mcleinn/freexen/README.md

Building blocks for a DIY 56*x key velocity-sensitive microtonal keyboard
