mcleinn/freexen/3DPrintingPlates/sheath_0.15_top0.13.3mf

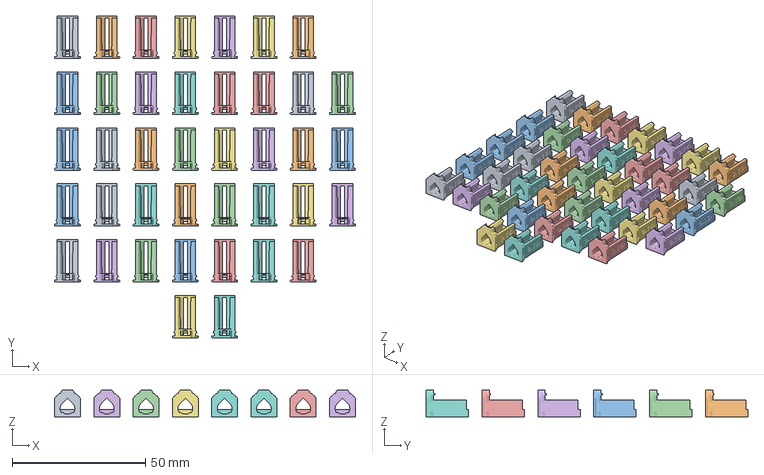
[picture p1: CAD file, 2025-05-10]
3DPrintingPlates/sheath_0.15_top0.13.3mf
113.0 x 120.8 x 10.0 mm
void_switch_15_op13.stl x 40
