mcleinn/freexen/xenCase/Shaft.stl

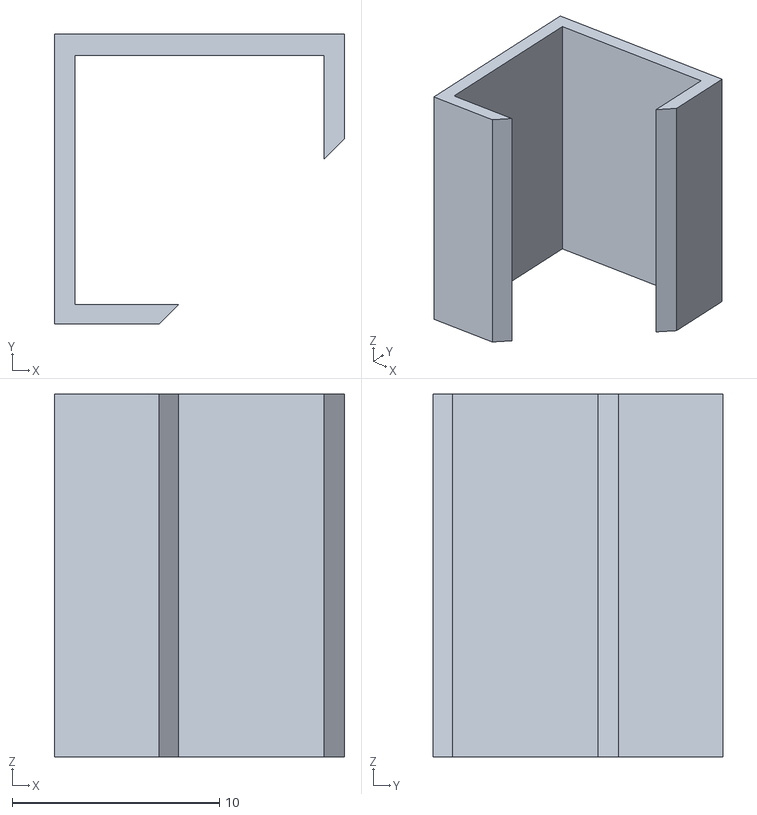
[picture p2: CAD file, 2025-02-27]
xenCase/Shaft.stl
14.0 x 14.0 x 17.5
