mcleinn/freexen/3DPrintingPlates/stem.3mf

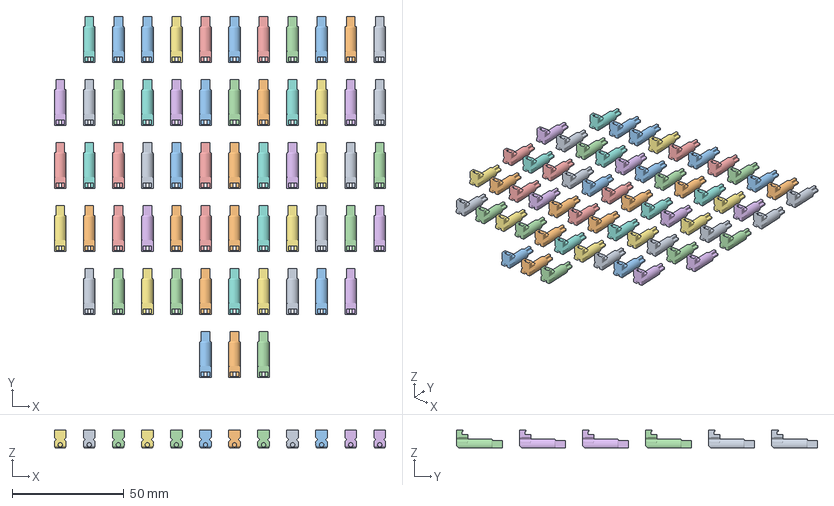
[picture p3: CAD file, 2025-03-23]
3DPrintingPlates/stem.3mf
148.6 x 161.8 x 7.93 mm
7.5_2.1_0.2_stem.stl x 60
