mcleinn/freexen/xenCase/module-top.stl

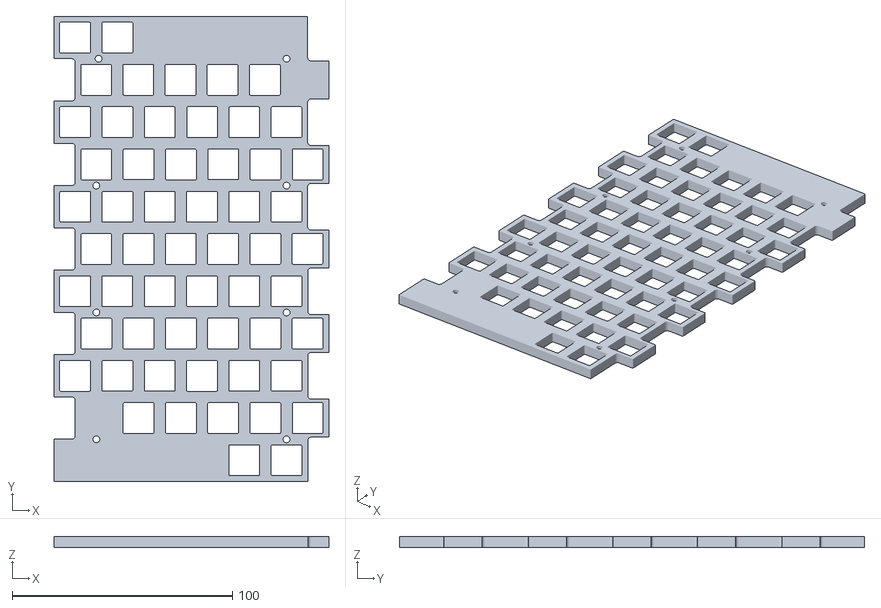
[picture p4: CAD file, 2025-02-27]
xenCase/module-top.stl
124.9 x 211.2 x 5.00
