mcleinn/freexen/3DPrintingPlates/module.3mf

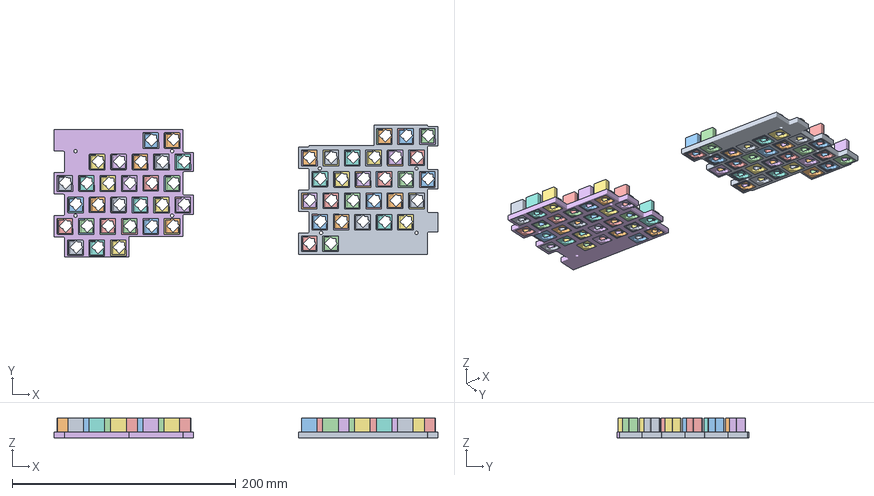
[picture p5: CAD file, 2025-02-27]
3DPrintingPlates/module.3mf
343.4 x 117.8 x 17.5 mm
Module-Top-B.stl
freexen-body.stl x 56
Module-Top-A.stl
Shaft.stl x 56
