mcleinn/freexen/xenCase/Module-Top-A.stl

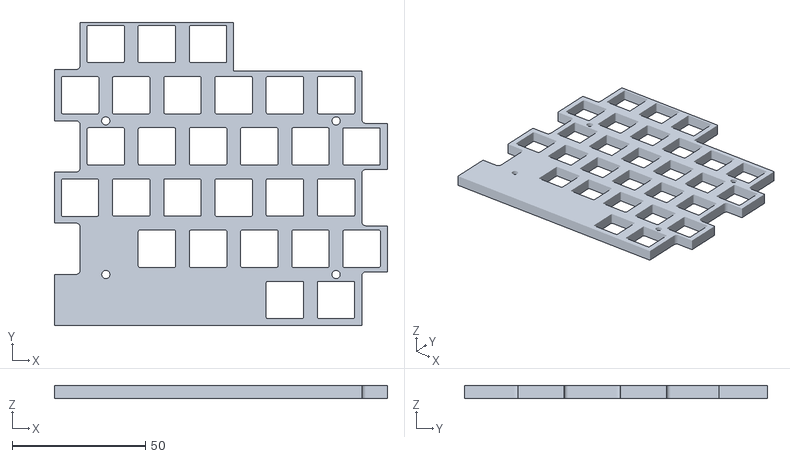
[picture p6: CAD file, 2025-02-27]
xenCase/Module-Top-A.stl
124.9 x 113.7 x 5.00
