mcleinn/freexen/3DPrintingPlates/assist-stems.3mf

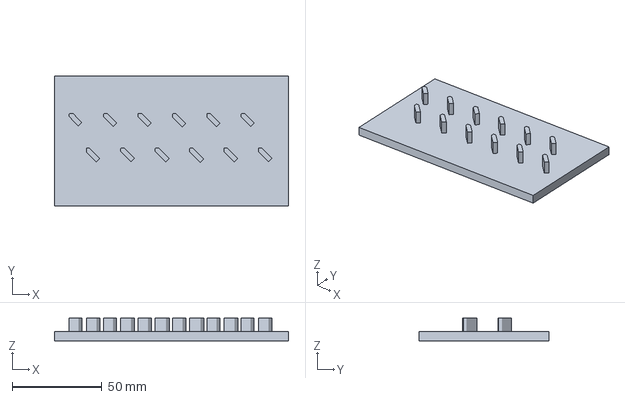
[picture p7: CAD file, 2025-02-27]
3DPrintingPlates/assist-stems.3mf
130.5 x 72.8 x 12.7 mm
