mcleinn/freexen/xenCase/Module-Top-B.stl

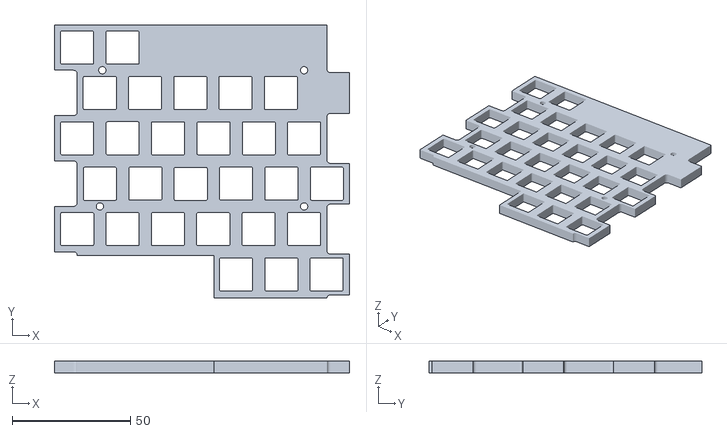
[picture p8: CAD file, 2025-02-27]
xenCase/Module-Top-B.stl
124.8 x 115.6 x 5.00
