mcleinn/freexen/3DPrintingPlates/assist-all.3mf

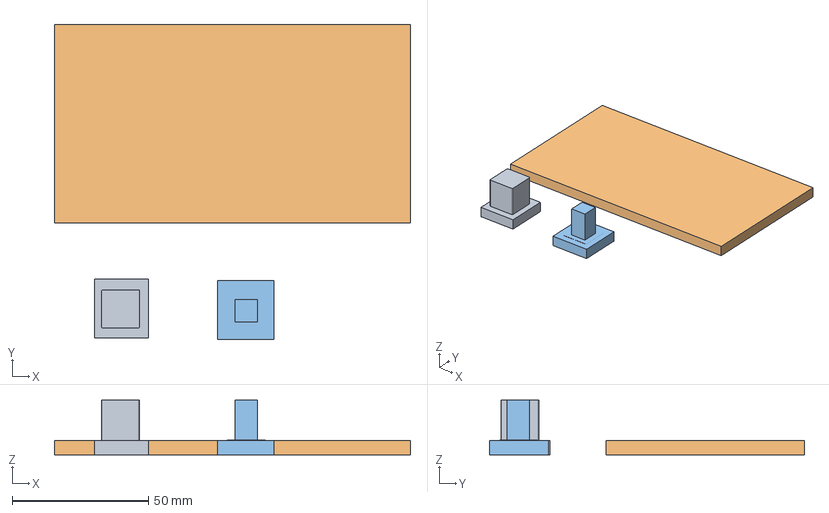
[picture p9: CAD file, 2025-02-27]
3DPrintingPlates/assist-all.3mf
130.5 x 115.4 x 20.0 mm
Assist Body.stl
Assist Plate.stl
assist-sheath.stl
