mcleinn/freexen/xenCase/frame-bay-open.dxf

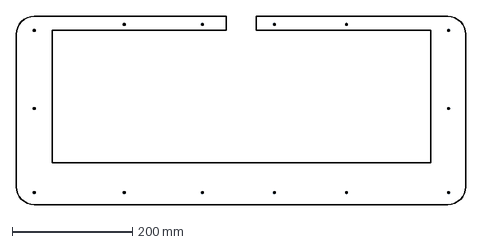
[picture p10: CAD file, 2025-02-24]
xenCase/frame-bay-open.dxf
748.7 x 313.2 mm
