mcleinn/freexen/3DPrintingPlates/bodies-wide.3mf

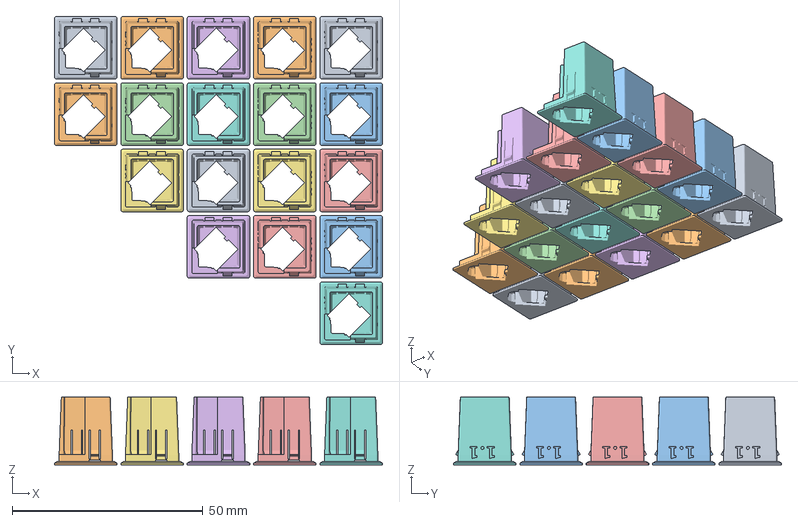
[picture p11: CAD file, 2025-02-24]
3DPrintingPlates/bodies-wide.3mf
86.0 x 86.0 x 17.7 mm
void_switch-wide.stl x 18
