mcleinn/freexen/xenCase/frame-bottom.dxf

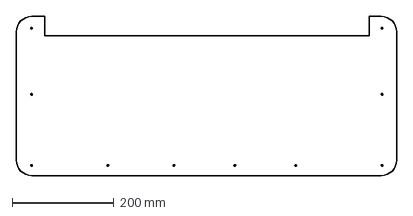
[picture p12: CAD file, 2025-02-24]
xenCase/frame-bottom.dxf
748.7 x 313.2 mm
