mcleinn/freexen/3DPrintingPlates/levitator.3mf

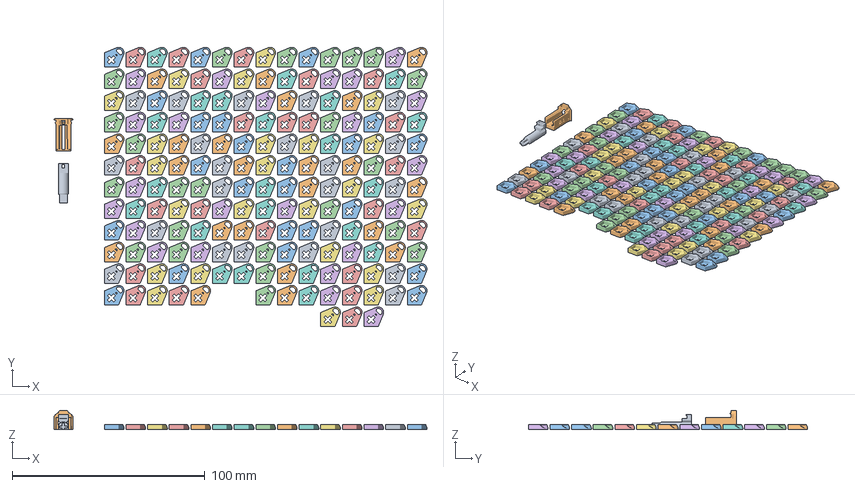
[picture p13: CAD file, 2025-02-24]
3DPrintingPlates/levitator.3mf
193.7 x 145.1 x 10.0 mm
7.5_2.1_0.2_stem.stl
7.5_2.1_0.15_sheath_wide.stl
levitator-my1.stl x 181
