mcleinn/freexen/xenCase/module_bottom.dxf

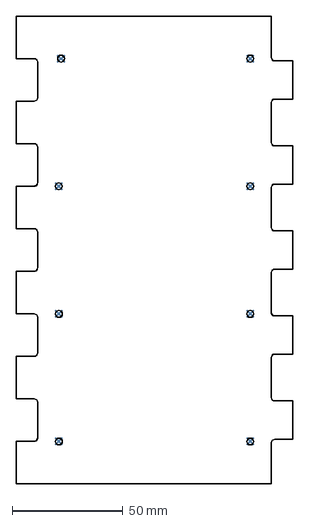
[picture p14: CAD file, 2025-02-24]
xenCase/module_bottom.dxf
124.8 x 211.2 mm
