mcleinn/freexen/3DPrintingPlates/sheath.3mf

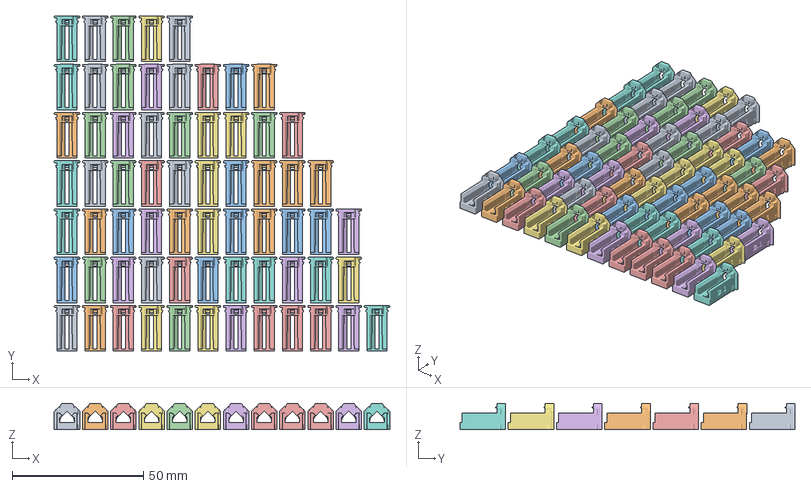
[picture p15: CAD file, 2025-02-24]
3DPrintingPlates/sheath.3mf
128.0 x 127.8 x 10.0 mm
sheath_longer.stl x 66
