mcleinn/freexen/xenCase/frame-middle.dxf

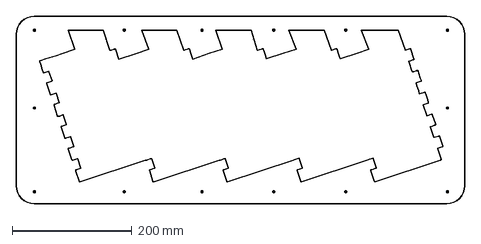
[picture p16: CAD file, 2025-02-24]
xenCase/frame-middle.dxf
748.7 x 313.2 mm
