mcleinn/freexen/3DPrintingPlates/bodies.3mf

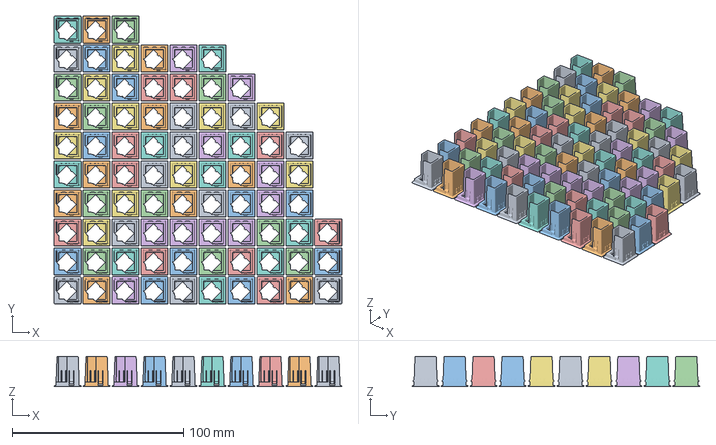
[picture p17: CAD file, 2025-02-24]
3DPrintingPlates/bodies.3mf
168.0 x 168.0 x 17.7 mm
mybody1.stl x 81
