mcleinn/freexen/xenCase/frame-bay-bottom.dxf

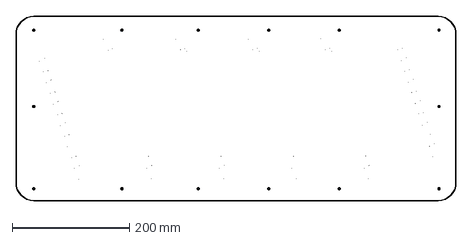
[picture p18: CAD file, 2025-02-24]
xenCase/frame-bay-bottom.dxf
748.7 x 313.2 mm
