mcleinn/freexen/3DPrintingPlates/sheath-stem.3mf

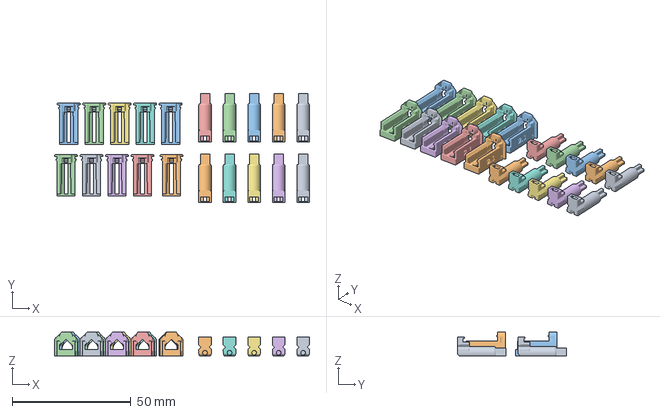
[picture p19: CAD file, 2025-02-24]
3DPrintingPlates/sheath-stem.3mf
107.6 x 46.2 x 10.0 mm
7.5_2.1_0.2_stem.stl x 10
sheath_longer.stl x 10
