mcleinn/freexen/xenCase/frame-top.dxf

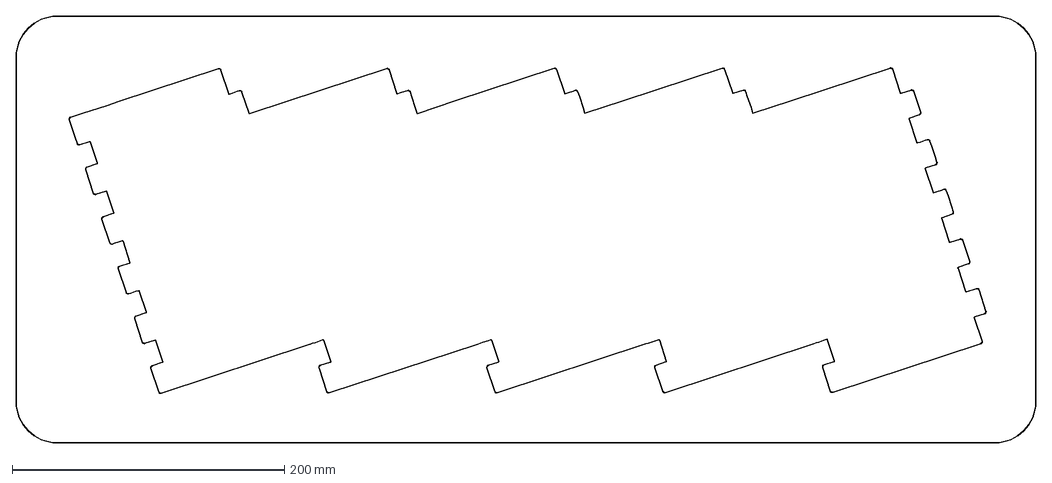
[picture p20: CAD file, 2025-02-24]
xenCase/frame-top.dxf
748.7 x 313.2 mm
