mcleinn/freexen/xenCase/frame-bay-closed.dxf

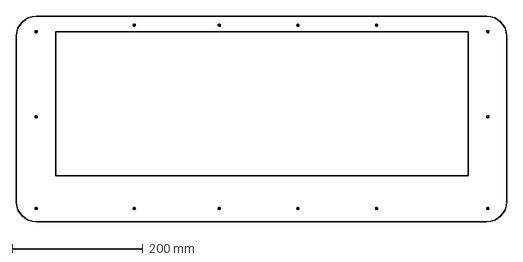
[picture p21: CAD file, 2025-02-24]
xenCase/frame-bay-closed.dxf
748.7 x 313.2 mm
