mcleinn/freexen/xenCase/dustcover.dxf

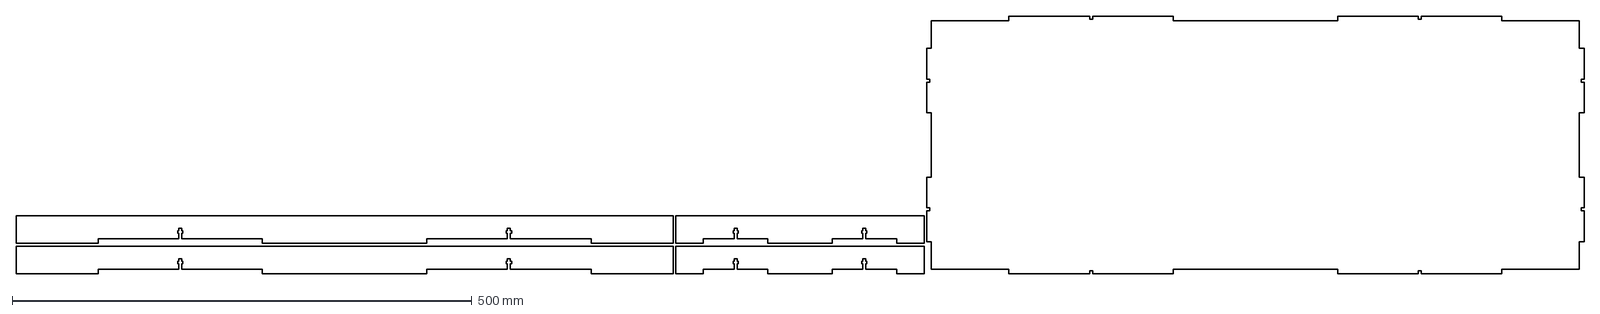
[picture p22: CAD file, 2025-02-24]
xenCase/dustcover.dxf
1706.0 x 280.0 mm
