mcleinn/freexen/xenCase/top_plane-felt.dxf

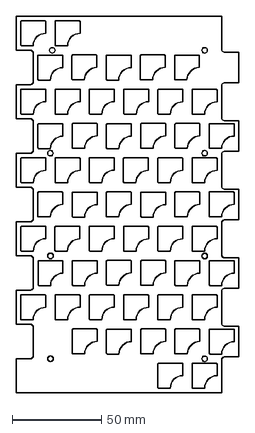
[picture p23: CAD file, 2025-02-24]
xenCase/top_plane-felt.dxf
124.8 x 211.2 mm
