mcleinn/freexen/(list of files, cad)

Other CAD files:
xenCase/module_top.dxf
