mcleinn/freexen/xenFirmware/XenTest2/TEST_LOG.md

# XenControl Firmware Test & Modification Log

This log is append-only. Each entry captures:
- firmware version (`ver`)
- date/time
- what changed
- key test results + brief analysis

## 2026-02-22 10:14:58

### fw=16

Tuning run: a4 + sd5

Results (COM3)
- `sd5` applied.
- `a4` applied.
- `rate1000` after a4+sd5:
  - muxStepsPerSec: 3864
  - keysPerSec: 6440
- `pr2` after a4+sd5 (head only):
  - sigma (keys 1..5): ~2.4–3.8 mV
  - `thrSuggest` mostly clamps at 30 mV
- `sts1,57` after a4+sd5:
  - best delay_us in {0,5,10,20,50,100,200}: 100 us
  - best score (maxErr): 8.159 mV
- `teste` after a4+sd5:
  - avg=4: keysPerSec ~43120, sigmaP95 ~7.74 mV
  - avg=8: keysPerSec ~23520, sigmaP95 ~7.30 mV
  - avg=16: keysPerSec ~12320, sigmaP95 ~6.38 mV
  - avg=32: keysPerSec ~6440,  sigmaP95 ~5.13 mV

Notes
- Settling sweep appears noisy/unstable across runs; we should pick a worst-case key pair explicitly and run multiple repetitions.
- Test output is still interleaved with peak-detect debug prints; add a quiet/test-only flag to suppress those during diagnostics.

Changes
- Reverted serial command parsing to leading-letters tokens.
- Renamed tests to letter-only commands (`testa..teste`).

Non-interactive test results (COM3)
- `rate1000`:
  - muxStepsPerSec: 3696
  - adcReadsPerSec / keysPerSec: 6182
  - full-scan-equivalent (280 keys): ~45 ms
- `pr2` (2s noise survey):
  - typical sigma: ~3–5 mV
  - `thrSuggest = max(30 mV, 8*sigma)` => often 30 mV clamp
  - most keys uncalibrated (`hasZero=0`), expected
- `sts1,57` (settle sweep, keyA=1 keyB=57, 50 samples):
  - best delay_us in {0,5,10,20,50,100,200}: 5 us
  - best score (maxErr): 6.749 mV
- `teste` (averaging sweep; p95 sigma vs throughput):
  - avg=1:  ~85960 keys/s, sigmaP95 ~14.36 mV
  - avg=2:  ~85960 keys/s, sigmaP95 ~14.14 mV
  - avg=4:  ~38360 keys/s, sigmaP95 ~7.77 mV
  - avg=8:  ~22120 keys/s, sigmaP95 ~7.29 mV
  - avg=16: ~12040 keys/s, sigmaP95 ~6.15 mV
  - avg=32: ~6440 keys/s,  sigmaP95 ~4.98 mV

Analysis
- Averaging sweet spot looks like 4 or 8 (big noise reduction vs large speed gain over 32).
- Mux settle delay could likely be reduced from 10 us to ~5 us, but should be re-tested on a worst-case key pair.
- Some debug prints suggest scan/peak logic may still run during tests; tests should run in a quiet mode for cleaner logs.

## 2026-02-22 10:20:03

### fw=16

Tuning run: a4 sd5 rate/pr/sts/teste

## 2026-02-22 10:22:00

### fw=17

Changes
- Added diagnostic mode gating so helpers/tests run without normal scanning or peak detection.
- Wrapped long-running helpers/tests with diag begin/end so they take over LEDs and timing.

Run (COM3)
- `fmt1`, `a4`, `sd5`
- `rate1000`
- `k1,280` + `pr2`
- `sts1,57`
- `teste`

Results
- `ver`: fw=17
- `rate1000` (after a4+sd5, diag mode):
  - muxStepsPerSec: 25872
  - keysPerSec: 43274
  - full-scan-equivalent (280 keys): ~6.5 ms
- `pr2` (2s noise survey, head):
  - typical sigma (keys 1..30): ~1.1–1.9 mV
  - `thrSuggest` still clamps at 30 mV for most keys
- `sts1,57` (settle sweep, 50 samples):
  - best delay_us in {0,5,10,20,50,100,200}: 50 us
  - best score (maxErr): 5.339 mV
  - observed outlier at 0 us (maxErrAB ~17.4 mV)
- `teste` (averaging sweep, p95 sigma vs throughput):
  - avg=1:  keysPerSec ~115640, sigmaP95 ~10.14 mV
  - avg=4:  keysPerSec ~43120,  sigmaP95 ~5.14 mV
  - avg=8:  keysPerSec ~23520,  sigmaP95 ~3.98 mV
  - avg=16: keysPerSec ~12320,  sigmaP95 ~2.86 mV
  - avg=32: keysPerSec ~6440,   sigmaP95 ~2.38 mV

Analysis
- With diag gating, rate/noise measurements are much cleaner and faster.
- Averaging sweet spot remains 4–8 depending on responsiveness vs cleanliness.
- Mux settle delay of 0 us can create rare but large carryover spikes; 10–50 us looks safer.

## 2026-02-22 10:34:00

### fw=18

Changes
- Added discard-first-sample ADC reads after each mux switch in runtime scan and noise scan.

Results (COM3)
- `teste` (averaging sweep, p95 sigma vs throughput):
  - avg=1:  keysPerSec ~85960, sigmaP95 ~12.39 mV
  - avg=2:  keysPerSec ~85960, sigmaP95 ~12.60 mV
  - avg=4:  keysPerSec ~38360, sigmaP95 ~5.69 mV
  - avg=8:  keysPerSec ~22120, sigmaP95 ~4.31 mV
  - avg=16: keysPerSec ~12040, sigmaP95 ~3.26 mV
  - avg=32: keysPerSec ~6440,  sigmaP95 ~2.59 mV

Analysis
- After discard-first-sample, avg=4 is still a good default for responsiveness.
- avg=8 is a nice "clean" mode with ~1.3x lower sigmaP95 than avg=4 but ~1.7x slower.

## 2026-02-22 10:40:00

### fw=19

Changes
- Set default ADC averaging to 4 on boot (previously 32).

Verification
- `ver`: fw=19

## 2026-02-22 12:54:02

### fw=28

Results (testb JSONL)
- `testb_done`: passCount=20 failCount=0 total=20 pass=1
- Typical baseline: ~1.66–1.73 V
- Typical sigma: ~1.3–2.0 mV
- Threshold used: 30 mV (minThr clamp)
- Notable low swing sentinel: key 169 (board 4 key 1) maxSwing ~58 mV (still passed)

testb full run (JSONL) pass=20 fail=0

## 2026-02-22 13:06:42

### fw=30

Results (testb JSONL)
- `testb_done`: passCount=23 failCount=0 total=23 pass=1
- Polarity distribution (from `testb_row.pol`): +1 = 16, -1 = 7
- Weakest sentinel: key 169 (board 4 key 1) maxSwing ~58.9 mV, pol=-1 (still passed at thr=30 mV)

testb updated: includes pol + extra subtest keys

## 2026-02-22 14:37:10

### fw=38

Calibrate board 1 (k1,56) after calib/testb parity

Run (COM3)
- Connected later (DTR) -> debug banner includes `fw=38` and `calibAutoLoadOk=0`.
- `fmt1`
- `k1,56`
- `ccalib`
- `x` (guided calibration for keys 1..56)

Key findings
- Calibration now emits `testb`-style baseline logs per key (baseline/sigma/thr/min/max) and uses discard-first-sample after mux switch during baseline capture.
- Key 3, which previously produced inflated sigma/threshold, calibrated normally.
- Calibration completed for all 56 keys with no issues:
  - `calib_done`: Skipped=0, NotTriggering=0, SelfTriggering=0, NotReleasing=0
- Persistence/coverage after run:
  - `calstat`: hasZero=56, hasThr=56, nSigma=56
  - observed sigma range on board 1: minSigma~0.001365, maxSigma~0.001911

## 2026-02-22 16:23:06

### fw=53

Calibrate board 3 (k113,168) with stuck-issue persistence

Run (COM3)
- `fmt1`
- `k113,168`
- `x` (guided calibration for board 3)

Results
- Overall after run: `calstat hasZero=167 hasThr=168 nSigma=168` (boards 1-3 attempted)
- After `scalib` + `lcalib`: `calstat hasZero=167 hasThr=167 nSigma=167`
- Board 3 coverage: `dcalib` shows 55/56 keys calibrated (1 key failed)

Issues (board 3)
- `calissues` for `k113,168`: `NotReleasing=1` (others 0)
- Failing key: global key 120 (1-based), board 3 key 8 (1-based)
  - JSON: `{"type":"calissue_row","key":119,"board":2,"boardKey":7,"notReleasing":1}`
- SD persistence: `dmeta` confirms the same key has `notReleasing=1`

Quality snapshot (board 3, calibrated keys)
- Weakest maxSwing: key 114 (boardKey 2) ~0.030155 V (near 30 mV clamp)
- Noisiest sigma: max ~0.001737 V (key 148 / boardKey 36)

## 2026-02-22 16:32:29

### fw=53

Calibrate boards 4 (k169,224) and 5 (k225,280)

Board 4 run (COM3)
- `fmt1`
- `k169,224`
- `x`

Board 4 results
- `calissues` for `k169,224`: Skipped=0, NotTriggering=0, SelfTriggering=0, NotReleasing=0, SlightlyStuck=0
- `dcalib` (board 4): 56/56 calibrated
- Polarity skew (board 4): pol+1=7, pol-1=49
- Sigma (board 4): min~0.001272, max~0.002519 (key 199 / boardKey 31 is the main outlier)
- Weakest maxSwing (board 4): key 170 (boardKey 2) ~0.030718 V (near 30 mV clamp)

Board 5 run (COM3)
- `fmt1`
- `k225,280`
- `x`

Board 5 results
- `calissues` for `k225,280`: Skipped=0, NotTriggering=0, SelfTriggering=0, NotReleasing=0, SlightlyStuck=0
- `dcalib` (board 5): 56/56 calibrated
- Sigma (board 5): min~0.001212, max~0.001753
- Weakest maxSwing (board 5): key 279 (boardKey 55) ~0.032776 V; key 277 (boardKey 53) ~0.033400 V

Overall after board 5
- `calstat`: hasZero=279, hasThr=279, nSigma=279 (one key still uncalibrated from board 3 NotReleasing)
- After `scalib` + `lcalib`: `calstat` unchanged

## 2026-02-22 17:43:18

### fw=56

Autotune avg/sd + per-key thresholds (RAM-only)

Goal
- Find runtime settings that yield `idle60 total=0` (no offenders) while keeping thresholds as low as possible.

Implementation notes (fw=56)
- `autotune<tuneSeconds>,<validateSeconds>,<candidateN>` now runs a fast grid search over global `avg` and `sd` using a short idle window, then for the top candidates does a one-shot per-key threshold raise based on observed max excursion (`maxExc + 5mV` margin), then strict-validates with `idle<validateSeconds>`.
- Logging is stored in RAM (single run) and dumped with `autodump` (non-spam during run).

Run (COM3)
- `fmt1`
- `k1,280`
- `autotune5,60,2`
- `autodump`
- `idle60`

Results
- `autodump` best: `bestAvg=32 bestSd_us=5 bestTuneTotal=0 bestValidateTotal=2` (not yet perfect)
- Manual `idle60` immediately after: `total=1` with top offender `key=8` (0-based) count=1

Analysis
- Short tune windows (5s) can miss rare spikes that appear in strict validation (60s). The one-shot threshold update based only on tune-window max excursion can therefore under-shoot slightly.
- Next improvement: if `validateTotal>0`, do a targeted adjustment step for keys that offend during validation (raise their thresholds using validation-window max excursion + margin), then re-validate until `total==0` or thresholds reach `maxThr`.

## 2026-02-22 18:26:14

### fw=58

Staged autotune (avg/sd grid + per-key thresholds)

Run (COM3)
- `fmt1`
- `k1,280`
- `autotune5,20,60,2`
- `autodump` (saved to local JSONL as well)
- `idle60` (post-check)

Result
- `autodump` best: `bestAvg=32 bestSd_us=5 bestTuneTotal=0 bestValidateTotal=0`
- Max threshold after tuning: `maxThr=0.048461` (key 86, 0-based)
- Threshold adjustments were minimal; only one key needed a raise in the winning candidate:
  - key 82 (0-based) maxExc~0.035779 -> thrAfter~0.045779

Local artifact
- `autotune_logs\autodump_fw58_20260222_181911.jsonl`

Notes
- This staged approach converged within the time budget and achieved strict `idle60 total=0` on the internal strict-validation stage.
- Post-check `idle60` should be re-run occasionally (and extended to `idle90`/`idle120`) to confirm rare spikes remain suppressed.

## 2026-02-22 20:47:31

### fw=66

Autotune bugfix: best candidate always set; idle120=0

Fix
- Autotune now always seeds `_autoBest*` from Stage A so `autodump` never reports INT_MAX sentinels.
- Strict loop now re-measures after each adjustment so `strictTotal` is always finite.
- `autodump` includes `complete` flag.

Run (COM3)
- `fmt1`
- `k1,280`
- `autotune5,20,120,2`
- external `idle120`
- `autodump` captured to local file

Results
- `idle120`: `total=0`
- `autodump` best: `bestAvg=32 bestSd_us=20 bestTuneTotal=0 bestValidateTotal=0`
- Threshold raises: none required (`maxThr=0.03` baseline)

Artifacts
- `autotune_logs\autodump_fw66_capture_20260222_204708.jsonl`

## 2026-02-23 18:08:53

### fw=90

Autotune saved (2-min defaults). LOW noise; idle120=1; overlay enabledKeys=279 avg=32 sd_us=100 maxThr=0.125V key=60; dynStepsMin=9 key=41 dynStepsMax=127 key=168 dynDeadN=0 scansPerSec=8 revisitMsEst=125ms
