mcleinn/freexen/(list of files, drawings)

Other design files:
xenControl/ProPrj_Xen_2025-02-04.epro
