mcleinn/freexen/xenIO/void_switch_keyboard.kicad_pcb

## KiCad design xenIO/void_switch_keyboard.kicad_pcb (2025-02-24)

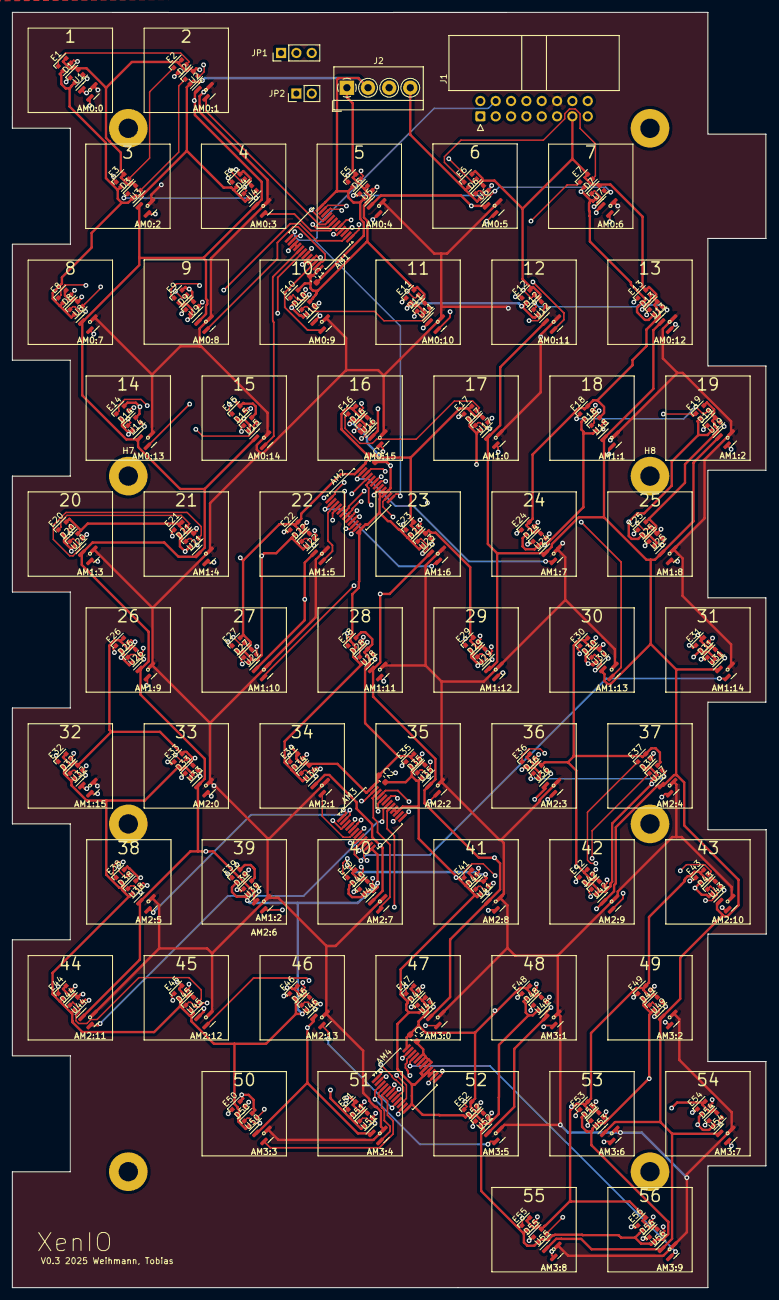
[picture p24: board void_switch_keyboard.kicad_pcb from above]

Board: 4 copper layers, 124.8 x 211.2 mm, 244 parts (0 on the bottom side), 183 nets.

Parts:
AM0:0: 1; VoidSwitch_1u_SMD
AM0:1: 2; VoidSwitch_1u_SMD
AM0:2: 3; VoidSwitch_1u_SMD
AM0:3: 4; VoidSwitch_1u_SMD
AM0:4: 5; VoidSwitch_1u_SMD
AM0:5: 6; VoidSwitch_1u_SMD
AM0:6: 7; VoidSwitch_1u_SMD
AM0:7: 8; VoidSwitch_1u_SMD
AM0:8: 9; VoidSwitch_1u_SMD
AM0:9: 10; VoidSwitch_1u_SMD
AM0:10: 11; VoidSwitch_1u_SMD
AM0:11: 12; VoidSwitch_1u_SMD
AM0:12: 13; VoidSwitch_1u_SMD
AM0:13: 14; VoidSwitch_1u_SMD
AM0:14: 15; VoidSwitch_1u_SMD
AM0:15: 16; VoidSwitch_1u_SMD
AM1, AM2, AM3, AM4: CD74HC4067SM; SSOP-24_5.3x8.2mm_P0.65mm
AM1:0: 17; VoidSwitch_1u_SMD
AM1:1: 18; VoidSwitch_1u_SMD
AM1:2: 19; VoidSwitch_1u_SMD
AM1:3: 20; VoidSwitch_1u_SMD
AM1:4: 21; VoidSwitch_1u_SMD
AM1:5: 22; VoidSwitch_1u_SMD
AM1:6: 23; VoidSwitch_1u_SMD
AM1:7: 24; VoidSwitch_1u_SMD
AM1:8: 25; VoidSwitch_1u_SMD
AM1:9: 26; VoidSwitch_1u_SMD
AM1:10: 27; VoidSwitch_1u_SMD
AM1:11: 28; VoidSwitch_1u_SMD
AM1:12: 29; VoidSwitch_1u_SMD
AM1:13: 30; VoidSwitch_1u_SMD
AM1:14: 31; VoidSwitch_1u_SMD
AM1:15: 32; VoidSwitch_1u_SMD
AM2:0: 33; VoidSwitch_1u_SMD
AM2:1: 34; VoidSwitch_1u_SMD
AM2:2: 35; VoidSwitch_1u_SMD
AM2:3: 36; VoidSwitch_1u_SMD
AM2:4: 37; VoidSwitch_1u_SMD
AM2:5: 38; VoidSwitch_1u_SMD
AM2:6: 39; VoidSwitch_1u_SMD
AM2:7: 40; VoidSwitch_1u_SMD
AM2:8: 41; VoidSwitch_1u_SMD
AM2:9: 42; VoidSwitch_1u_SMD
AM2:10: 43; VoidSwitch_1u_SMD
AM2:11: 44; VoidSwitch_1u_SMD
AM2:12: 45; VoidSwitch_1u_SMD
AM2:13: 46; VoidSwitch_1u_SMD
AM3:0: 47; VoidSwitch_1u_SMD
AM3:1: 48; VoidSwitch_1u_SMD
AM3:2: 49; VoidSwitch_1u_SMD
AM3:3: 50; VoidSwitch_1u_SMD
AM3:4: 51; VoidSwitch_1u_SMD
AM3:5: 52; VoidSwitch_1u_SMD
AM3:6: 53; VoidSwitch_1u_SMD
AM3:7: 54; VoidSwitch_1u_SMD
AM3:8: 55; VoidSwitch_1u_SMD
AM3:9: 56; VoidSwitch_1u_SMD
C1, C2, C3, C4: 0.1uF; C_0603_1608Metric
D1, D2, D3, D4, D5, D6, D7, D8, D9, D10, D11, D12, D13, D14, D15, D16, D17, D18, D19, D20, D21, D22, D23, D24, D25, D26, D27, D28, D29, D30, D31, D32, D33, D34, D35, D36, D37, D38, D39, D40, D41, D42, D43, D44, D45, D46, D47, D48, D49, D50, D51, D52, D53, D54, D55, D56: WS2812B-2020; LED_WS2812B-2020_PLCC4_2.0x2.0mm
E1, E2, E3, E4, E5, E6, E7, E8, E9, E10, E11, E12, E13, E14, E15, E16, E17, E18, E19, E20, E21, E22, E23, E24, E25, E26, E27, E28, E29, E30, E31, E32, E33, E34, E35, E36, E37, E38, E39, E40, E41, E42, E43, E44, E45, E46, E47, E48, E49, E50, E51, E52, E53, E54, E55, E56: WS2812B-2020; LED_WS2812B-2020_PLCC4_2.0x2.0mm
H1, H2, H3, H4, H5, H6, H7, H8: MountingHole; MountingHole_3.2mm_M3_Pad
J1: CONTROLLER; IDC-Header_2x08_P2.54mm_Horizontal
J2: PWR; TerminalBlock_4Ucon_1x04_P3.50mm_Horizontal
JP1: JMP_LED1; PinHeader_1x03_P2.54mm_Vertical
JP2: JMP_LED2; PinHeader_1x02_P2.54mm_Vertical
U1, U2, U3, U4, U5, U6, U7, U8, U9, U10, U11, U12, U13, U14, U15, U16, U17, U18, U19, U20, U21, U22, U23, U24, U25, U26, U27, U28, U29, U30, U31, U32, U33, U34, U35, U36, U37, U38, U39, U40, U41, U42, U43, U44, U45, U46, U47, U48, U49, U50, U51, U52, U53, U54, U55, U56: GH39FKSW; SOT-23

Connections:
AM0: AM1.1 (COM), J1.5
AM0:0: AM1.9 (I0), U1.2 (OUT)
AM0:1: AM1.8 (I1), U2.2 (OUT)
AM0:2: AM1.7 (I2), U3.2 (OUT)
AM0:3: AM1.6 (I3), U4.2 (OUT)
AM0:4: AM1.5 (I4), U5.2 (OUT)
AM0:5: AM1.4 (I5), U6.2 (OUT)
AM0:6: AM1.3 (I6), U7.2 (OUT)
AM0:7: AM1.2 (I7), U8.2 (OUT)
AM0:8: AM1.23 (I8), U9.2 (OUT)
AM0:9: AM1.22 (I9), U10.2 (OUT)
AM0:10: AM1.21 (I10), U11.2 (OUT)
AM0:11: AM1.20 (I11), U12.2 (OUT)
AM0:12: AM1.19 (I12), U13.2 (OUT)
AM0:13: AM1.18 (I13), U14.2 (OUT)
AM0:14: AM1.17 (I14), U15.2 (OUT)
AM0:15: AM2.9 (I0), U16.2 (OUT)
AM1: AM2.1 (COM), J1.6
AM1:0: AM2.8 (I1), U17.2 (OUT)
AM1:1: AM2.7 (I2), U18.2 (OUT)
AM1:2: AM2.6 (I3), U19.2 (OUT)
AM1:3: AM2.5 (I4), U20.2 (OUT)
AM1:4: AM2.4 (I5), U21.2 (OUT)
AM1:5: AM2.3 (I6), U22.2 (OUT)
AM1:6: AM2.2 (I7), U23.2 (OUT)
AM1:7: AM2.23 (I8), U24.2 (OUT)
AM1:8: AM2.22 (I9), U25.2 (OUT)
AM1:9: AM2.21 (I10), U26.2 (OUT)
AM1:10: AM2.20 (I11), U27.2 (OUT)
AM1:11: AM2.19 (I12), U28.2 (OUT)
AM1:12: AM2.18 (I13), U29.2 (OUT)
AM1:13: AM2.17 (I14), U30.2 (OUT)
AM1:14: AM3.9 (I0), U31.2 (OUT)
AM1:15: AM3.8 (I1), U32.2 (OUT)
AM2: AM3.1 (COM), J1.7
AM2:0: AM3.7 (I2), U33.2 (OUT)
AM2:1: AM3.6 (I3), U34.2 (OUT)
AM2:2: AM3.5 (I4), U35.2 (OUT)
AM2:3: AM3.4 (I5), U36.2 (OUT)
AM2:4: AM3.3 (I6), U37.2 (OUT)
AM2:5: AM3.2 (I7), U38.2 (OUT)
AM2:6: AM3.23 (I8), U39.2 (OUT)
AM2:7: AM3.22 (I9), U40.2 (OUT)
AM2:8: AM3.21 (I10), U41.2 (OUT)
AM2:9: AM3.20 (I11), U42.2 (OUT)
AM2:10: AM3.19 (I12), U43.2 (OUT)
AM2:11: AM3.18 (I13), U44.2 (OUT)
AM2:12: AM3.17 (I14), U45.2 (OUT)
AM2:13: AM4.9 (I0), U46.2 (OUT)
AM3: AM4.1 (COM), J1.8
AM3:0: AM4.8 (I1), U47.2 (OUT)
AM3:1: AM4.7 (I2), U48.2 (OUT)
AM3:2: AM4.6 (I3), U49.2 (OUT)
AM3:3: AM4.5 (I4), U50.2 (OUT)
AM3:4: AM4.4 (I5), U51.2 (OUT)
AM3:5: AM4.3 (I6), U52.2 (OUT)
AM3:6: AM4.2 (I7), U53.2 (OUT)
AM3:7: AM4.23 (I8), U54.2 (OUT)
AM3:8: AM4.22 (I9), U55.2 (OUT)
AM3:9: AM4.21 (I10), U56.2 (OUT)
GNDLED: AM1.12 (GND), AM1.15 (~E), AM1.16 (I15), AM2.12 (GND), AM2.15 (~E), AM2.16 (I15), AM3.12 (GND), AM3.15 (~E), AM3.16 (I15), AM4.12 (GND), AM4.15 (~E), AM4.16 (I15), AM4.17 (I14), AM4.18 (I13), AM4.19 (I12), AM4.20 (I11), C1.2, C2.2, C3.2, C4.2, D1.2 (VSS), D2.2 (VSS), D3.2 (VSS), D4.2 (VSS), D5.2 (VSS), D6.2 (VSS), D7.2 (VSS), D8.2 (VSS), D9.2 (VSS), D10.2 (VSS), D11.2 (VSS), D12.2 (VSS), D13.2 (VSS), D14.2 (VSS), D15.2 (VSS), D16.2 (VSS), D17.2 (VSS), D18.2 (VSS), D19.2 (VSS), D20.2 (VSS), D21.2 (VSS), D22.2 (VSS), D23.2 (VSS), D24.2 (VSS), D25.2 (VSS), D26.2 (VSS), D27.2 (VSS), D28.2 (VSS), D29.2 (VSS), D30.2 (VSS), D31.2 (VSS), D32.2 (VSS), D33.2 (VSS), D34.2 (VSS), D35.2 (VSS), D36.2 (VSS), D37.2 (VSS), D38.2 (VSS), D39.2 (VSS), D40.2 (VSS), D41.2 (VSS), D42.2 (VSS), D43.2 (VSS), D44.2 (VSS), D45.2 (VSS), D46.2 (VSS), D47.2 (VSS), D48.2 (VSS), D49.2 (VSS), D50.2 (VSS), D51.2 (VSS), D52.2 (VSS), D53.2 (VSS), D54.2 (VSS), D55.2 (VSS), D56.2 (VSS), E1.2 (VSS), E2.2 (VSS), E3.2 (VSS), E4.2 (VSS), E5.2 (VSS), E6.2 (VSS), E7.2 (VSS), E8.2 (VSS), E9.2 (VSS), E10.2 (VSS), E11.2 (VSS), E12.2 (VSS), E13.2 (VSS), E14.2 (VSS), E15.2 (VSS), E16.2 (VSS), E17.2 (VSS), E18.2 (VSS), E19.2 (VSS), E20.2 (VSS), E21.2 (VSS), E22.2 (VSS), E23.2 (VSS), E24.2 (VSS), E25.2 (VSS), E26.2 (VSS), E27.2 (VSS), E28.2 (VSS), E29.2 (VSS), E30.2 (VSS), E31.2 (VSS), E32.2 (VSS), E33.2 (VSS), E34.2 (VSS), E35.2 (VSS), E36.2 (VSS), E37.2 (VSS), E38.2 (VSS), E39.2 (VSS), E40.2 (VSS), E41.2 (VSS), E42.2 (VSS), E43.2 (VSS), E44.2 (VSS), E45.2 (VSS), E46.2 (VSS), E47.2 (VSS), E48.2 (VSS), E49.2 (VSS), E50.2 (VSS), E51.2 (VSS), E52.2 (VSS), E53.2 (VSS), E54.2 (VSS), E55.2 (VSS), E56.2 (VSS), J1.15, J1.16, J2.2, J2.4
GNDSENSOR: J1.12, U1.3 (GND), U2.3 (GND), U3.3 (GND), U4.3 (GND), U5.3 (GND), U6.3 (GND), U7.3 (GND), U8.3 (GND), U9.3 (GND), U10.3 (GND), U11.3 (GND), U12.3 (GND), U13.3 (GND), U14.3 (GND), U15.3 (GND), U16.3 (GND), U17.3 (GND), U18.3 (GND), U19.3 (GND), U20.3 (GND), U21.3 (GND), U22.3 (GND), U23.3 (GND), U24.3 (GND), U25.3 (GND), U26.3 (GND), U27.3 (GND), U28.3 (GND), U29.3 (GND), U30.3 (GND), U31.3 (GND), U32.3 (GND), U33.3 (GND), U34.3 (GND), U35.3 (GND), U36.3 (GND), U37.3 (GND), U38.3 (GND), U39.3 (GND), U40.3 (GND), U41.3 (GND), U42.3 (GND), U43.3 (GND), U44.3 (GND), U45.3 (GND), U46.3 (GND), U47.3 (GND), U48.3 (GND), U49.3 (GND), U50.3 (GND), U51.3 (GND), U52.3 (GND), U53.3 (GND), U54.3 (GND), U55.3 (GND), U56.3 (GND)
LDIN: D1.3 (DIN), J1.9
LDIN2: E1.3 (DIN), JP1.1 (A)
LDOUT: J1.10, JP1.3 (B), JP2.2 (B)
LDOUT1: D56.1 (DOUT), JP1.2 (C)
LDOUT2: E56.1 (DOUT), JP2.1 (A)
unnamed: D1.1 (DOUT), D2.3 (DIN)
unnamed: D2.1 (DOUT), D3.3 (DIN)
unnamed: D3.1 (DOUT), D4.3 (DIN)
unnamed: D4.1 (DOUT), D5.3 (DIN)
unnamed: D5.1 (DOUT), D6.3 (DIN)
unnamed: D6.1 (DOUT), D7.3 (DIN)
unnamed: D7.1 (DOUT), D8.3 (DIN)
unnamed: D8.1 (DOUT), D9.3 (DIN)
unnamed: D9.1 (DOUT), D10.3 (DIN)
unnamed: D10.1 (DOUT), D11.3 (DIN)
unnamed: D11.1 (DOUT), D12.3 (DIN)
unnamed: D12.1 (DOUT), D13.3 (DIN)
unnamed: D13.1 (DOUT), D14.3 (DIN)
unnamed: D14.1 (DOUT), D15.3 (DIN)
unnamed: D15.1 (DOUT), D16.3 (DIN)
unnamed: D16.1 (DOUT), D17.3 (DIN)
unnamed: D17.1 (DOUT), D18.3 (DIN)
unnamed: D18.1 (DOUT), D19.3 (DIN)
unnamed: D19.1 (DOUT), D20.3 (DIN)
unnamed: D20.1 (DOUT), D21.3 (DIN)
unnamed: D21.1 (DOUT), D22.3 (DIN)
unnamed: D22.1 (DOUT), D23.3 (DIN)
unnamed: D23.1 (DOUT), D24.3 (DIN)
unnamed: D24.1 (DOUT), D25.3 (DIN)
unnamed: D25.1 (DOUT), D26.3 (DIN)
unnamed: D26.1 (DOUT), D27.3 (DIN)
unnamed: D27.1 (DOUT), D28.3 (DIN)
unnamed: D28.1 (DOUT), D29.3 (DIN)
unnamed: D29.1 (DOUT), D30.3 (DIN)
unnamed: D30.1 (DOUT), D31.3 (DIN)
unnamed: D31.1 (DOUT), D32.3 (DIN)
unnamed: D32.1 (DOUT), D33.3 (DIN)
unnamed: D33.1 (DOUT), D34.3 (DIN)
unnamed: D34.1 (DOUT), D35.3 (DIN)
unnamed: D35.1 (DOUT), D36.3 (DIN)
unnamed: D36.1 (DOUT), D37.3 (DIN)
unnamed: D37.1 (DOUT), D38.3 (DIN)
unnamed: D38.1 (DOUT), D39.3 (DIN)
unnamed: D39.1 (DOUT), D40.3 (DIN)
unnamed: D40.1 (DOUT), D41.3 (DIN)
unnamed: D41.1 (DOUT), D42.3 (DIN)
unnamed: D42.1 (DOUT), D43.3 (DIN)
unnamed: D43.1 (DOUT), D44.3 (DIN)
unnamed: D44.1 (DOUT), D45.3 (DIN)
unnamed: D45.1 (DOUT), D46.3 (DIN)
unnamed: D46.1 (DOUT), D47.3 (DIN)
unnamed: D47.1 (DOUT), D48.3 (DIN)
unnamed: D48.1 (DOUT), D49.3 (DIN)
unnamed: D49.1 (DOUT), D50.3 (DIN)
unnamed: D50.1 (DOUT), D51.3 (DIN)
unnamed: D51.1 (DOUT), D52.3 (DIN)
unnamed: D52.1 (DOUT), D53.3 (DIN)
unnamed: D53.1 (DOUT), D54.3 (DIN)
unnamed: D54.1 (DOUT), D55.3 (DIN)
unnamed: D55.1 (DOUT), D56.3 (DIN)
unnamed: E1.1 (DOUT), E2.3 (DIN)
unnamed: E2.1 (DOUT), E3.3 (DIN)
unnamed: E3.1 (DOUT), E4.3 (DIN)
unnamed: E4.1 (DOUT), E5.3 (DIN)
unnamed: E5.1 (DOUT), E6.3 (DIN)
unnamed: E6.1 (DOUT), E7.3 (DIN)
unnamed: E7.1 (DOUT), E8.3 (DIN)
unnamed: E8.1 (DOUT), E9.3 (DIN)
unnamed: E9.1 (DOUT), E10.3 (DIN)
unnamed: E10.1 (DOUT), E11.3 (DIN)
unnamed: E11.1 (DOUT), E12.3 (DIN)
unnamed: E12.1 (DOUT), E13.3 (DIN)
unnamed: E13.1 (DOUT), E14.3 (DIN)
unnamed: E14.1 (DOUT), E15.3 (DIN)
unnamed: E15.1 (DOUT), E16.3 (DIN)
unnamed: E16.1 (DOUT), E17.3 (DIN)
unnamed: E17.1 (DOUT), E18.3 (DIN)
unnamed: E18.1 (DOUT), E19.3 (DIN)
unnamed: E19.1 (DOUT), E20.3 (DIN)
unnamed: E20.1 (DOUT), E21.3 (DIN)
unnamed: E21.1 (DOUT), E22.3 (DIN)
unnamed: E22.1 (DOUT), E23.3 (DIN)
unnamed: E23.1 (DOUT), E24.3 (DIN)
unnamed: E24.1 (DOUT), E25.3 (DIN)
unnamed: E25.1 (DOUT), E26.3 (DIN)
unnamed: E26.1 (DOUT), E27.3 (DIN)
unnamed: E27.1 (DOUT), E28.3 (DIN)
unnamed: E28.1 (DOUT), E29.3 (DIN)
unnamed: E29.1 (DOUT), E30.3 (DIN)
unnamed: E30.1 (DOUT), E31.3 (DIN)
unnamed: E31.1 (DOUT), E32.3 (DIN)
unnamed: E32.1 (DOUT), E33.3 (DIN)
unnamed: E33.1 (DOUT), E34.3 (DIN)
unnamed: E34.1 (DOUT), E35.3 (DIN)
unnamed: E35.1 (DOUT), E36.3 (DIN)
unnamed: E36.1 (DOUT), E37.3 (DIN)
unnamed: E37.1 (DOUT), E38.3 (DIN)
unnamed: E38.1 (DOUT), E39.3 (DIN)
unnamed: E39.1 (DOUT), E40.3 (DIN)
unnamed: E40.1 (DOUT), E41.3 (DIN)
unnamed: E41.1 (DOUT), E42.3 (DIN)
unnamed: E42.1 (DOUT), E43.3 (DIN)
unnamed: E43.1 (DOUT), E44.3 (DIN)
unnamed: E44.1 (DOUT), E45.3 (DIN)
unnamed: E45.1 (DOUT), E46.3 (DIN)
unnamed: E46.1 (DOUT), E47.3 (DIN)
unnamed: E47.1 (DOUT), E48.3 (DIN)
unnamed: E48.1 (DOUT), E49.3 (DIN)
unnamed: E49.1 (DOUT), E50.3 (DIN)
unnamed: E50.1 (DOUT), E51.3 (DIN)
unnamed: E51.1 (DOUT), E52.3 (DIN)
unnamed: E52.1 (DOUT), E53.3 (DIN)
unnamed: E53.1 (DOUT), E54.3 (DIN)
unnamed: E54.1 (DOUT), E55.3 (DIN)
unnamed: E55.1 (DOUT), E56.3 (DIN)
SELECT0: AM1.10 (S0), AM2.10 (S0), AM3.10 (S0), AM4.10 (S0), J1.1
SELECT1: AM1.11 (S1), AM2.11 (S1), AM3.11 (S1), AM4.11 (S1), J1.2
SELECT2: AM1.14 (S2), AM2.14 (S2), AM3.14 (S2), AM4.14 (S2), J1.3
SELECT3: AM1.13 (S3), AM2.13 (S3), AM3.13 (S3), AM4.13 (S3), J1.4
VLED: AM1.24 (VCC), AM2.24 (VCC), AM3.24 (VCC), AM4.24 (VCC), C1.1, C2.1, C3.1, C4.1, D1.4 (VDD), D2.4 (VDD), D3.4 (VDD), D4.4 (VDD), D5.4 (VDD), D6.4 (VDD), D7.4 (VDD), D8.4 (VDD), D9.4 (VDD), D10.4 (VDD), D11.4 (VDD), D12.4 (VDD), D13.4 (VDD), D14.4 (VDD), D15.4 (VDD), D16.4 (VDD), D17.4 (VDD), D18.4 (VDD), D19.4 (VDD), D20.4 (VDD), D21.4 (VDD), D22.4 (VDD), D23.4 (VDD), D24.4 (VDD), D25.4 (VDD), D26.4 (VDD), D27.4 (VDD), D28.4 (VDD), D29.4 (VDD), D30.4 (VDD), D31.4 (VDD), D32.4 (VDD), D33.4 (VDD), D34.4 (VDD), D35.4 (VDD), D36.4 (VDD), D37.4 (VDD), D38.4 (VDD), D39.4 (VDD), D40.4 (VDD), D41.4 (VDD), D42.4 (VDD), D43.4 (VDD), D44.4 (VDD), D45.4 (VDD), D46.4 (VDD), D47.4 (VDD), D48.4 (VDD), D49.4 (VDD), D50.4 (VDD), D51.4 (VDD), D52.4 (VDD), D53.4 (VDD), D54.4 (VDD), D55.4 (VDD), D56.4 (VDD), E1.4 (VDD), E2.4 (VDD), E3.4 (VDD), E4.4 (VDD), E5.4 (VDD), E6.4 (VDD), E7.4 (VDD), E8.4 (VDD), E9.4 (VDD), E10.4 (VDD), E11.4 (VDD), E12.4 (VDD), E13.4 (VDD), E14.4 (VDD), E15.4 (VDD), E16.4 (VDD), E17.4 (VDD), E18.4 (VDD), E19.4 (VDD), E20.4 (VDD), E21.4 (VDD), E22.4 (VDD), E23.4 (VDD), E24.4 (VDD), E25.4 (VDD), E26.4 (VDD), E27.4 (VDD), E28.4 (VDD), E29.4 (VDD), E30.4 (VDD), E31.4 (VDD), E32.4 (VDD), E33.4 (VDD), E34.4 (VDD), E35.4 (VDD), E36.4 (VDD), E37.4 (VDD), E38.4 (VDD), E39.4 (VDD), E40.4 (VDD), E41.4 (VDD), E42.4 (VDD), E43.4 (VDD), E44.4 (VDD), E45.4 (VDD), E46.4 (VDD), E47.4 (VDD), E48.4 (VDD), E49.4 (VDD), E50.4 (VDD), E51.4 (VDD), E52.4 (VDD), E53.4 (VDD), E54.4 (VDD), E55.4 (VDD), E56.4 (VDD), J1.13, J1.14, J2.1, J2.3
VSENS: J1.11, U1.1 (VDD), U2.1 (VDD), U3.1 (VDD), U4.1 (VDD), U5.1 (VDD), U6.1 (VDD), U7.1 (VDD), U8.1 (VDD), U9.1 (VDD), U10.1 (VDD), U11.1 (VDD), U12.1 (VDD), U13.1 (VDD), U14.1 (VDD), U15.1 (VDD), U16.1 (VDD), U17.1 (VDD), U18.1 (VDD), U19.1 (VDD), U20.1 (VDD), U21.1 (VDD), U22.1 (VDD), U23.1 (VDD), U24.1 (VDD), U25.1 (VDD), U26.1 (VDD), U27.1 (VDD), U28.1 (VDD), U29.1 (VDD), U30.1 (VDD), U31.1 (VDD), U32.1 (VDD), U33.1 (VDD), U34.1 (VDD), U35.1 (VDD), U36.1 (VDD), U37.1 (VDD), U38.1 (VDD), U39.1 (VDD), U40.1 (VDD), U41.1 (VDD), U42.1 (VDD), U43.1 (VDD), U44.1 (VDD), U45.1 (VDD), U46.1 (VDD), U47.1 (VDD), U48.1 (VDD), U49.1 (VDD), U50.1 (VDD), U51.1 (VDD), U52.1 (VDD), U53.1 (VDD), U54.1 (VDD), U55.1 (VDD), U56.1 (VDD)
