mcleinn/freexen/xenFirmware/XenTest2/src/adc.h

#ifndef ADC_H
#define ADC_H

#include <Arduino.h>

#define NUM_ADCS            4
#define ADC_UNSCALED1       0
#define ADC_UNSCALED2       1

const int BOARDS_PER_ADC_CHANNEL = 3;
const short _adcPins[NUM_ADCS] = { A2, A5, 0, 0 };
const float ADC_VREF = 3.3;       // Reference voltage in volts
const int ADC_RESOLUTION = 12;
const int ADC_RESOLUTION_MAX = 4095;  // 10 bit 1023, 12 bit 4095

void setupADC();
float getAdcVoltage(int channel);
int getAdcUnscaled(int key);
int getAdcUnscaledRawByIndex(int adcIndex);

extern int _measureAvgStandard;

#endif // ADC_H
