mcleinn/freexen/(commit log)

2025-02-24 Initial upload
    [ProPrj_Xen_2025-02-04.epro, dustcover.dxf, frame-bay-bottom.dxf, frame-bay-closed.dxf, frame-bay-open.dxf, frame-bottom.dxf, frame-middle.dxf, frame-top.dxf]
2025-02-24 Adding 3D printing plates
    [bodies-wide.3mf, bodies.3mf, levitator.3mf, sheath-stem.3mf, sheath.3mf, stem.3mf]
2025-02-27 Fix issues before presentation
    [Module-Top-A.stl, Module-Top-B.stl, Shaft.stl, assist-all.3mf, assist-stems.3mf, module-top.stl, module.3mf, module_top.dxf]
2025-03-23 Add VisualStudioCode project
    [stem.3mf]
2025-05-10 Improve development/debugging system
    [sheath_0.15_top0.13.3mf]
2026-02-21 Checkpoint current calibration and debug changes
2026-02-22 Fix calibration persistence and diagnostics
    [adc.cpp, adc.h, calib.cpp, calib.h, led.cpp, log_test_entry.py, main.cpp]
2026-02-22 Add calibration issue persistence and meta dump
    [calib.cpp, calib.h, main.cpp, main.h, serial_calibrate_example.py]
2026-02-22 Fix autotune best selection and add idle120 validation
    [calib.cpp, main.cpp]
2026-02-23 Reapply post-68 firmware fixes
    [calib.cpp, calib.h, main.cpp, main.h, mux.cpp]
2026-02-23 Add boot drift compensation and commands
    [calib.cpp, calib.h, main.cpp]
2026-02-23 Restore calibration slot backup/restore commands
2026-02-23 Add JSONL output for calib slot commands
2026-02-23 Remove autotune maxThr clamp
2026-02-23 Pause normal scanning on debug attach
2026-02-23 Add scan rate and dynamics step metrics; add baseline drift tracker
    [calib.cpp, main.cpp]
2026-02-23 Add noiselevel/noisereset commands and metrics
    [main.cpp, main.h]
2026-02-23 Add noise and calibration tools guide
2026-02-23 Document calibration, baseline drift, and autotune layers
